edf1101/LaserTag/hardware/README.md

# Hardware

This folder contains files to required for the circuity.

## Electronics
- All components required are listed here [Bill of Materials](BOM_LaserTag.csv)
- Schematic for the main circuit board is available [here](Schematic_LaserTag.pdf)
- PCB design files for the main board are available [here](PCB.pdf)
- Gerber files are available [here](Gerber_LaserTag.zip)
