edf1101/LaserTag/src/Gamemodes/README.md

# /Gamemodes

This directory contains code required for gamemodes. Gamemodes are the different ways and match styles you can play Laser Tag.
Each gamemode is a separate class that inherits from the abstract `Gamemode` class.
