edf1101/LaserTag/hardware/BOM_LaserTag.csv

Main Body PCB
ID | Name | Designator | Footprint | Description | Quantity
1 | JST-PH-2 | JST1, JST2, JST3, JST4, JST5 | JST PH 2 PIN | 2 Pin JST headers | 5
2 | JST-PH-3 | JST6, JST7, JST8 | JST PH 3-PIN 2.0MM TOP ENTRY | 3 Pin JST headers | 3
3 | JST-PH-4 | JST9 | JST-PH-4-HEADER | 4 Pin JST headers | 1
4 | PC817 | O1 | PC817-DIP | Optoisolator | 1
5 | 2N2222A | Q2,Q3,Q1 | TO-92-3_L4.8-W3.7-P2.54-R | Transistors | 3
6 | NDP6020 | Q4 | TO-220AB-3_L10.3-W5.0-P2.54-L | Power Mosfet | 1
7 | 1K | R2, R3, R4, R5, R6, R7 | R0603 | 1k Resistor | 6
8 | 10k | R8,R9,R10, R11, R12, R13 | R0603 | 10k resistor | 4
9 | 100k | R14,R15,R16,R17 | R0603 | 100k resistor | 4
10 | 470 | R23 | TH-RESISTOR-VERTICAL | 470 resistor | 1
11 | ESP32 Mini | U1 | ESP32 TTGO MINI32 | Mini ESP32 | 1
12 | ULN2003 | U3 | ULN2003APG-DIP | LED amplifying IC | 1
13 | VS1838B | IR1, IR2, IR3 | IR LED VS1838B | IR recievers | 3
14 | 100uf | C1 | CAPACITOR-TH-CERAMIC-DISK-5MM | 100uf capacitor | 1
15 | MAX98357A | AMP1 | MAX98357A | I2S amplifier | 1
16 | 1N5819W | D1,D2,D3 | 1N5819W_SS14 | diodes | 3
17 | 5.6 | R18 | R0603 | 5.6 resistor | 1
18 | 100 | R19 | R0603 | 100 resistor | 1
19 | 220 | R21,R22 | R0603 | 220 resistor | 2
20 | Rotary Encoder | SW1 | ROTARYENCODER | rotary encoder | 1
21 | 1.8in TFT display | TFT1 | 1.8 LCD TFT ST7735S WAVESHARE | TFT display | 1
22 | MCP23008-DIP | U2 | MCP23008 SOIC-18_300MIL | GPIO extension IC | 1
TOTAL |  |  |  |  | 46
Extras
ID | Name | Quantity
1 | IR LED | 1
2 | Orange LED | 2
3 | VS1838B IR reciever | 1
4 | 5 pixel Neopixel strip | 1
5 | Vibration motor | 1
6 | SPST Push button | 2
7 | 8ohm 1.5w Speaker | 1
8 | JST-PH 2-pin Male wire | 5
9 | JST-PH 3-pin Male wire | 3
10 | JST-PH 4-pin Male wire | 1
11 | I2C OLED display | 1
12 | Machine pins Male/female | Many
13 | Batteries | 4-5v worth
