edf1101/LaserTag/res/Usage.md

# Usage

_This page describes how to use the Laser Tag system._
