edf1101/LaserTag/hardware/PCB.pdf

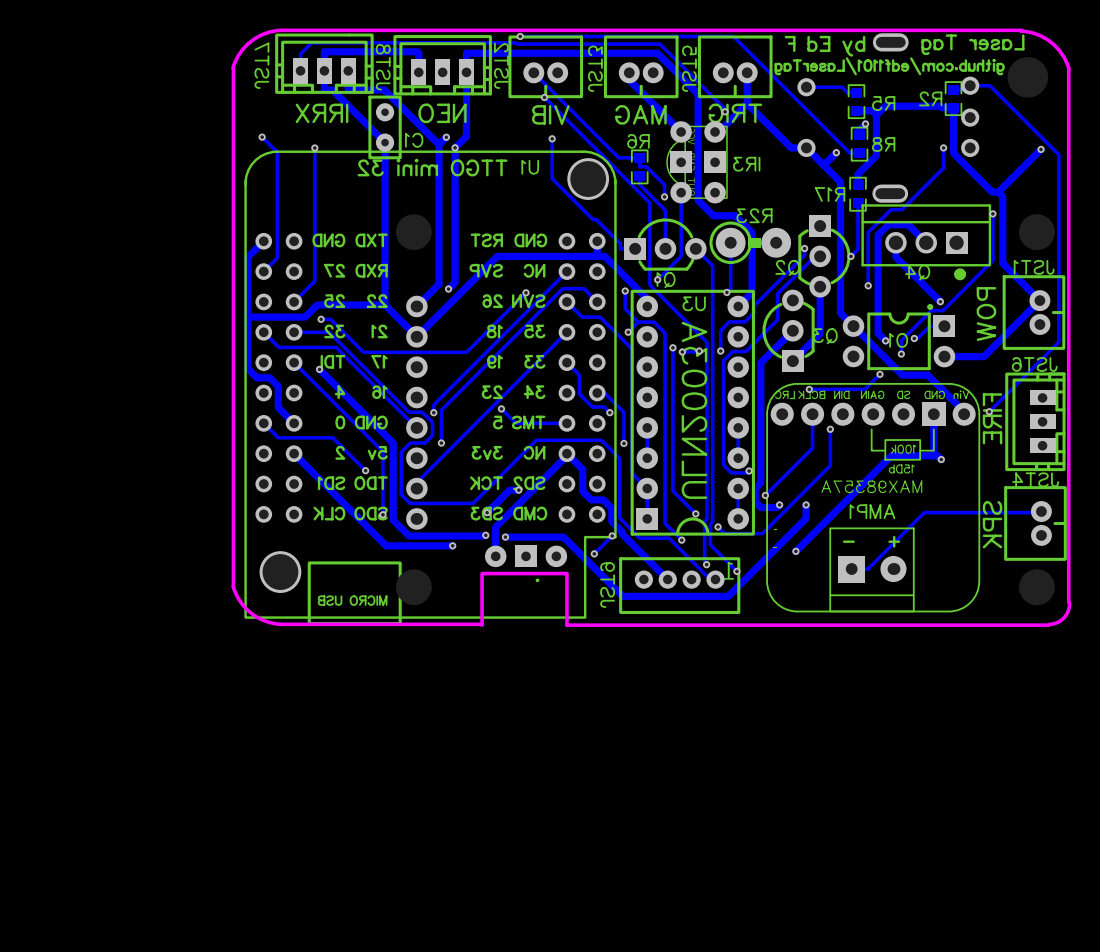
[picture p1: page 1]

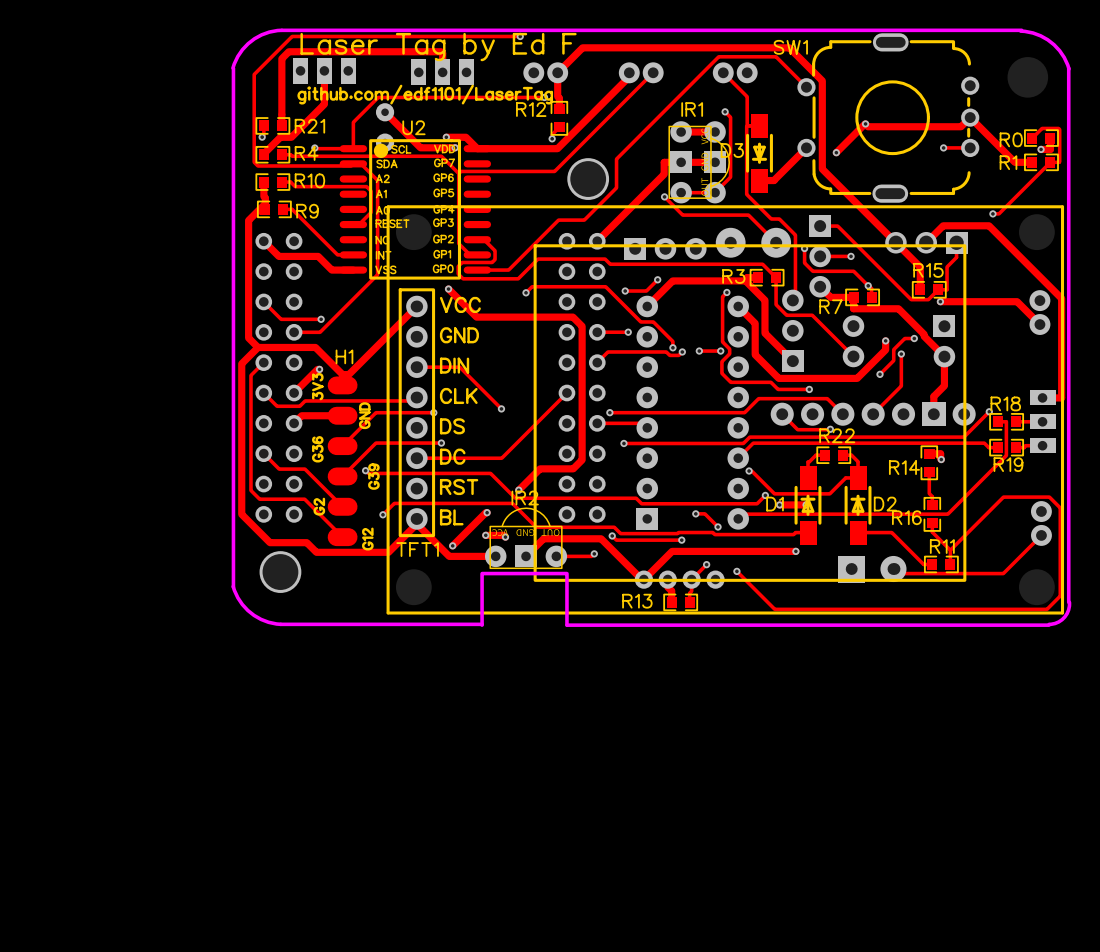
[picture p2: page 2]
