edf1101/LaserTag/hardware/Schematic_LaserTag.pdf

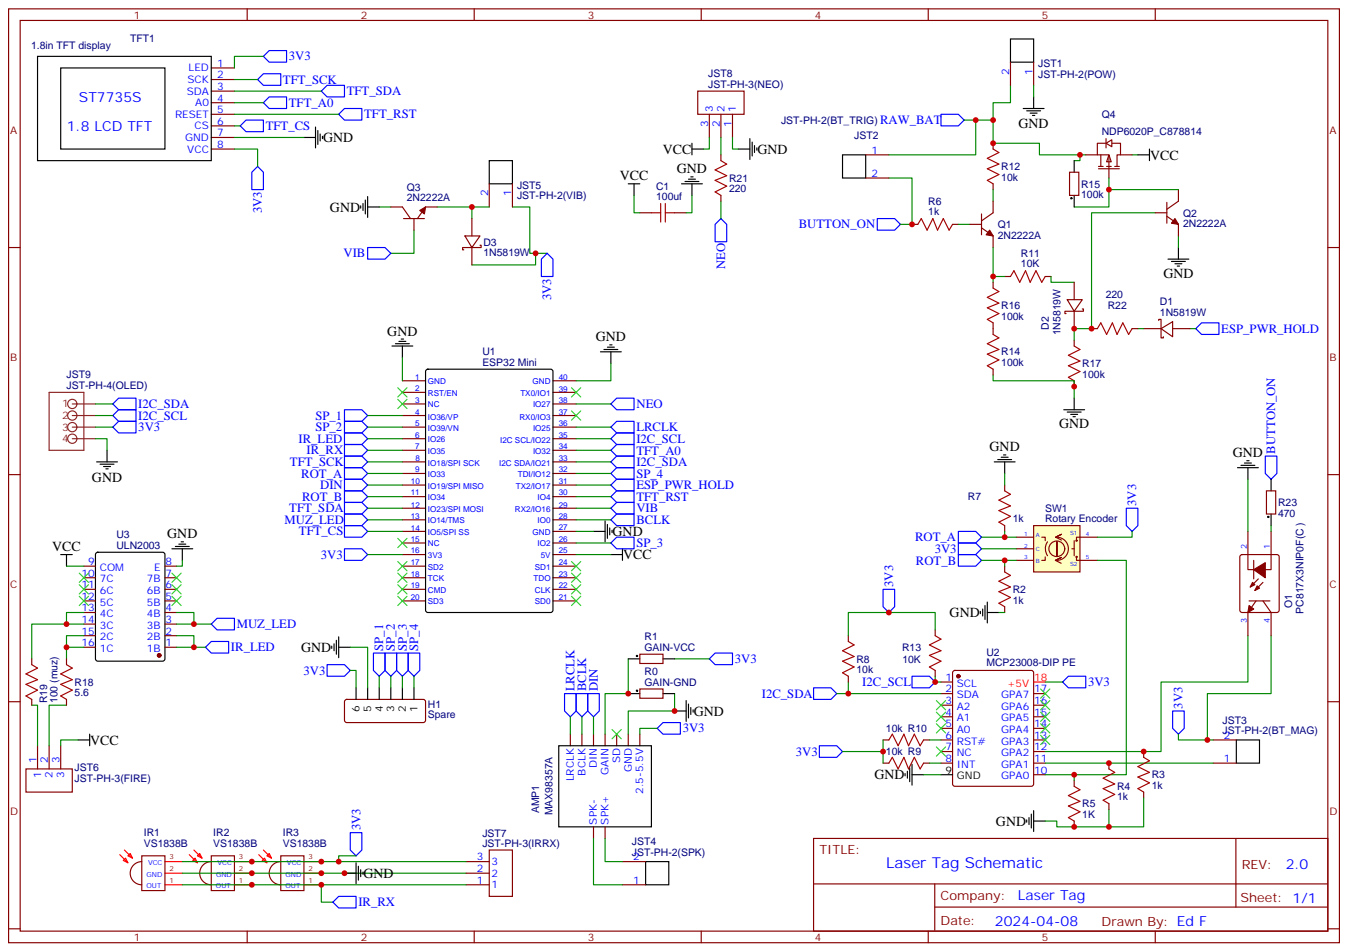
[picture p3: page 1]
