edf1101/LaserTag/(list of files, drawings)

Other design files:
hardware/EasyEDA files/PCB_PCB_LaserTag-TTGO_2024-07-18.json
hardware/EasyEDA files/SCH_LaserTag-TTGO_2024-07-18.json
