edf1101/LaserTag/src/Pins.h

/*
 * Created by Ed Fillingham on 09/04/2024.
 *
 * This file contains definitions for various pins on the ESP32 board and where they are used.
*/

#ifndef LASERTAG_PINS_H
#define LASERTAG_PINS_H

// Pin definitions for the side display
#define TFT_CS 14
#define TFT_RST 15
#define TFT_DC 32

// Pin definitions for the rotary encoder
#define ROT_OUT_A 17
#define ROT_OUT_B 5
#define ROT_SWITCH 19

// Pin definitions for IR Transmitter & Receiver
#define IR_RECEIVER GPIO_NUM_35
#define IR_TRANSMITTER GPIO_NUM_26
#define MUZZLE_LED 13

// Pin definitions for the buttons
#define TRIGGER_BUTTON 12
#define MAGAZINE_BUTTON 16

// Speaker pins
#define DAC_PIN 25


#endif //LASERTAG_PINS_H
