edf1101/LaserTag/(commit log)

2024-04-09 Image displaying framework done
    Able to store images in a logical and intuitive way then load them in and display them
2024-04-09 basic side display class impl and rotary encoder handling
2024-04-09 arduino IDE compatible
    Made arduino IDE compatible as possible and tools to make it completely so.
2024-04-10 Ir / firing basics
    Tested to compile to Arduino IDE
2024-04-10 bugfixes for Arduino IDE compilation
2024-04-11 Button code
    can get current state and has event callbacks for press down and release
2024-04-11 Basics of weapons firing / interlinking with button callbacks
    - Arduino IDE compatible
    - Gun fires when button is down
    - Basic gun tryFire mechanism
    - Gun is now a part of player
    next up:
    - ammo decreasing
    - reloading
2024-04-14 couple more widgets + HUD handling in game
    - couple more widgets
    - HUD handling in game
    - Gamemode manager
    - Solo and None selected gamemodes in the works
2024-04-18 Neopixel LED system
2024-04-22 Bug fixes
    Modified neopixel library so it works with IR RMT timings happily
    [LaserTag.cpp]
2024-06-26 Interrupt based rotary encoder
    - lib cleanup / better gitattributes to ignore those files from linguist
2024-07-06 Rotary Encoder Update
    - Rotary Encoder knob and press now uses button interface
    - Last activity so it turns off if nothing done recently
    - Rotary knob direction bug fixed
    - you can now get which nodes are active recently.
    [Button.cpp, Button.h, Buttons.h, LaserTag.cpp, RotaryEncoderWrapper.cpp]
2024-07-12 Infinite Mags Ammo Lives etc.
    - Now implemented and working
    - Displays on the HUD too
    - Bug fix: Commands now send over IR
    [Firing.cpp]
2024-07-12 Can set guns / gun groups on the command system
    - Can set / change guns and gun groups on the command system
    - Bug fixes
    [CommandManager.cpp, Firing.cpp, LaserTag.cpp]
2024-07-14 Transistor to turn amplifier on and off added
    - Will probably replace the audio with I2S soon, but good to have a backup here
    [LaserTag.cpp]
2024-07-19 new amplifier
    - Fixed side display bug
    - now uses better I2S sound
    [LaserTag.cpp]
2024-07-20 More new hardware changes
    - Power latch off and on
    - Sound system improvements
    - Minor folder refactor
2024-07-20 Logger
    - Made a proprietary logger
    - swapped all old serial print statements to use logger instead
    [CommandManager.cpp, Firing.cpp, Hardware.cpp, HudDisplay.cpp, LaserTag.cpp, LaserTag.h]
